WB2CBA/W5BAA-FT8-POCKET-TERMINAL/FT8 POCKET TEENSY 3.6/Pocket-FT8_Project Manual_May_2022.pdf

### Pocket FT8: A Palm Size FT 8 Decoder / Encoder For SOTA

Scope
This document is written to help you build your own self contained FT8 Rig. Listed below are the main features of the project.
- Small Size, 3.5” X 2.75” X 1.125”
- Mono Audio Input and Output for Transceiver Interface
- PTT Output To Control Transceiver
- SD Card Contact Logging
- 320 X 480 Resistive Color Touch Screen
- GPS Receiver For Setting Teensy Real Time Clock and Station Maidenhead Locator

Attributions
This project is based on the FT8 Decoding Library by Karlis Goba: https://github.com/kgoba/ft8_lib

DSP Audio Architecture
Decoding FT8 requires significant data storage and processing speed.

The Teensy Audio Library has been modified to allow Analog to Digital conversion to be run at the rate of 32000 samples per second. The receive data is decimated by a factor of 5. This allows Receive Audio Data Processing to be done at 6400 Hz. The 6400 Hz audio processing rate with a 2048 FFT to process the received audio for FT8 decoding yields a bin spacing of 3.125 Hz.

The algorithms developed by Karlis Goba use the 3.125 Hz spaced FFT bins to be screened in both frequency and time so that errors in symbol frequency and time reception can be overcome to provide really great FT8 decoding. The end spacing of the FT8 algorithms is 6.25 Hz as required by FT8 protocol.

Target Transceiver
This unit has been designed to directly interface with the popular uSDX transceivers such as the uSDX Mono and the uSDX Tri-Band Pocket Radio.


The photo below shows the pocket_FT8 display on boot up.

The FT8_Log.txt is the filename used to store operating log data. The line “W5BAA:EM00 is the raw text stored in a file entitled “Station_Data.txt” which you create to store your station details.
The lines “W5BAA” and “EM00” is the parsed station data.

The Synchronizing With RTC and FT8 Synched With World Lines are displayed at startup while the unit synchronizes the FT8 decode algorithm with the Teensy 3.6 Real Time Clock.

Finally, the last line in green shows the revision level of the software.


Decoded FT8 Signals

This photo shows decoded signals after the unit is synchronized. Up to ten FT8 Signals may be decoded and displayed per FT8 period.

Overall Architecture
The project consists of the following hardware modules:

Teensy 3.6
The Teensy 3.6 is ideal for this application since it has both Analog to Digital (ADC) inputs and Digital to Analog (DAC) outputs. This allows the DSP algorithms to be implemented with minimal parts count.

The Teensy 3.6 is supported by the feature rich Teensy Audio Library found here: https://www.pjrc.com/teensy/td_libs_Audio.html

The original source for the Teensy 3.6 may be found here: https://www.pjrc.com/store/teensy36.html Unfortunately, PJRC has been out of stock for some time.

A viable alternative may be Ali Express as shown below.

https://nl.aliexpress.com/item/3256803451619522.html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 45650&crea=en1005003637934274&netw=u&device=c&albpg=1480551745650&albpd=en10050036 37934274&gclid=Cj0KCQjw-JyUBhCuARIsANUqQ_KSC-1gYJm9mQVjuHfPr4Px892twd8chFpD1A1u9B4owOFrEE6DkJgaAnG5EALw_wcB&gclsrc=aw.ds& aff_fcid=03a8c9757c6340c082a8e60e83739c5a-1653047603438-09475-UneMJZVf&aff_fsk=UneMJZVf&aff_platform=aaf&sk=UneMJZVf&aff_trace_key=03a8c9757c6340 c082a8e60e83739c5a-1653047603438-09475-UneMJZVf&terminal_id=699c94115ff747c3adbf46e954a344ee&afSmartRedirect=y&gatewayAdapt= 4itemAdapt (https://nl.aliexpress.com/item/3256803451619522.html?_randl_currency=USD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)

Adafruit 320 X 480 TFT Touchscreen https://learn.adafruit.com/adafruit-3-5-color-320x480-tft-touchscreen-breakout

Microchip MCP 3422 Analog to Digital IC https://www.microchip.com/en-us/product/MCP3422

u-blox NEO-6M GPS Module with Battery Backup
https://www.amazon.com/GY-GPS6MV2-NEO6MV2-Antenna-Arduino-Control/dp/B07QMTM5YM

The Teensy 3.6 communicates with the MCP 3244 A/D via an I2C Bus while the Touchscreen Display is interfaced via an SPI Bus.

The Microchip MCP 3422 Analog to Digital IC is used to interface the Touch Screen touch point coordinates to the Teensy processor. One may ask “Why not use two of the Analog Pins on the Teensy?”. An attempt was made to do just this. However, the high rate of A to D sampling required by the Teensy Audio Library swamps out polling of the touch screen analog data. So, the MCP3422 is used so the touch point data may be fed to the Teensy 3.6 via the I2C Bus.

The Teensy communicates with the GPS receiver via a serial data port. The GPS data is interfaced using the NEMA protocol. The software uses the NEMA data to set the RTC and Station Maidenhead Locator.

## Module Connections

The project connections are shown on the drawing shown below.

The unit may be assembled using perf board and wire wrap wire to make connections between modules.

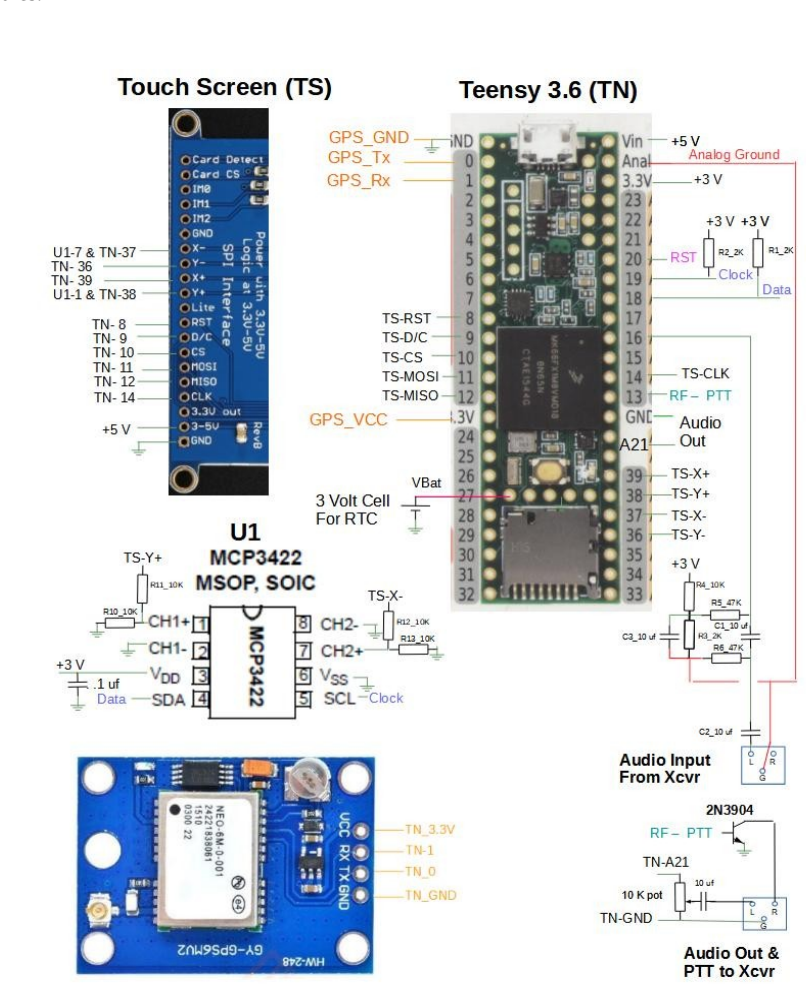
[picture p12: figure]

## Adafruit 480 X 320 Display Gotcha!

The Adafruit Display requires that you fill in solder bridge IM2 in order to put the display in the SPI Interface mode. If you do not install this bridge you will only get a totally white screen.


## GPS Receiver NEMA Sentences

The application software uses the TinyGPS.h library for parsing the NEMA sentences produced by the GPS receiver module. This library uses the NEMA GPRMC Sentence or the GPGGA Sentence to provide date time data. So, please ensure that your GPS module produces one of these two sentences.

## Installing Firmware on Teensy 3.6

The firmware is loaded by using the USB Serial bootloader provided with the Teensy 3.6.

When you first connect the Teensy to your computer using a USB be patient and allow the Teensy and Computer go thru the handshaking ritual to establish the serial connection.

The firmware is supplied as a hex file which can be loaded with the TEENSY.EXE application. You can download TEENSY.EXE from this site: https://www.pjrc.com/teensy/loader_win10.html

This website has complete instructions on using TEENSY.EXE.

The Pocket_FT8 firmware is provided as a file such as : Pocket_FT8_GPS_OCT_2021_2.ino.TEENSY36.hex

A screen shot of the firmware being loaded is shown below:


Real Time Clock
The Teensy Real Time Clock (RTC) is used to display relative time and to mark log entries with date – time groups.

The software may be manually synchronized using the touch screen button marked “SYNC”. This technique is copied from the work done by Karlis Goba and is a very effective way to manually sync the Pocket_FT8 rig with the current worldwide FT8 traffic.

A 3 volt coin cell battery is required to be connected to the Vbat pin on the Teensy 3.6 to make the RTC work.

Setting Your Call and Location
Your call and location data are stored on an SD Card as simple text file. Use Notepad to create a text file called “Station_Data.txt”.

The content of this file should be a single line in the form of YourCall:Madienhead_Locator.

For example here is the line I use: W5BAA:EM00.

Pocket_FT8 User Operation


The unit uses the Portrait Mode of display and the hardware has been designed so that the Pocket_FT8 may be operated in your hand. The unit shown above is my prototype.

The user is presented with a number of data displays, touch buttons and touch areas as shown above.

Display Items
Starting at the top, the received audio / FT8 spectrum / waterfall is shown. The vertical red line on the spectrum display shows the FT8 transmit audio frequency.

Immediately below the waterfall the RTC Time is displayed as the default option. If the GPS mode of setting your Maidenhead location is activated, the GPS Time is displayed to the right of the RTC time.

In the middle pane the received FT8 traffic is shown. Up to ten FT8 signals may be decoded and displayed for each FT8 period.

Touch Areas

Two touch areas are provided.

One is the FT8 waterfall. Touching this area moves the FT8 transmit audio frequency. The red vertical line moves to show the selected FT8 transmit audio frequency.

The other touch area is immediately below the RTC Date Time or GPS time line. You may touch one of the displayed FT8 messages to capture the call sign of the transmitting station. The call of the selected station is displayed above the two rows of touch buttons displayed at the bottom of the screen.

In the example shown below on the left, the message “CQ AA9RR EN62 1708” has been touched to capture the call sign “AA9RR”.

Further, the “CALL” button has been touched to compose the message “ AA9RR W5BAA EM00” as shown below on the right.

The value “1708” shown in the decoded FT8 message is the distance between Maidenhead Locator EN62 and Maidenhead Locator EM00, my station Locator.


Touch Buttons

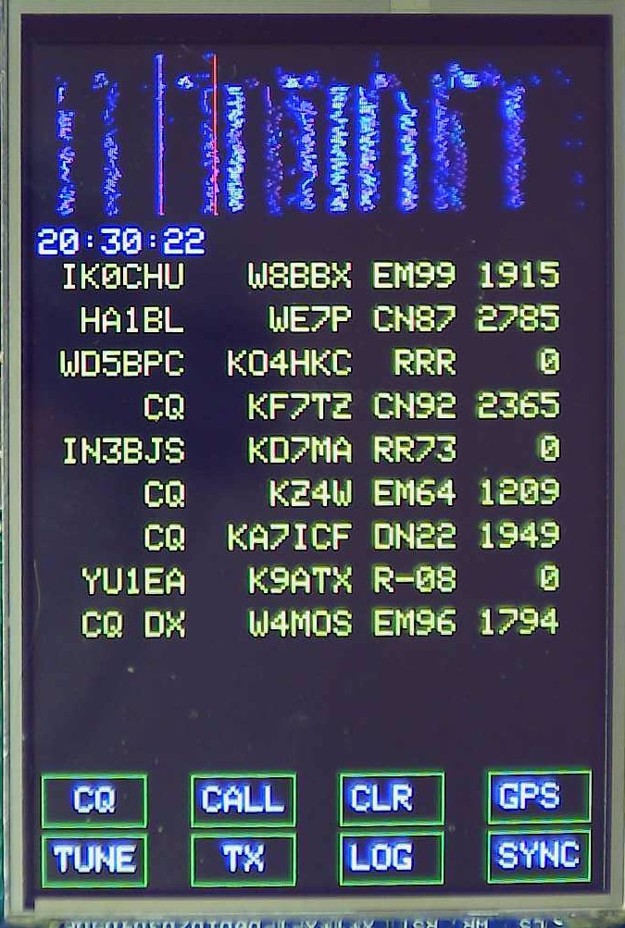
[picture p13: figure]

Ten touch buttons are displayed at the bottom of the screen. The buttons will be displayed with a Green or Red outline as explained below:

CQ places the unit in the beacon (CQ ing) mode. Red means CQ mode is selected.

Call places the unit in the QSO mode. Red means the QSO mode is selected.

CLR clears the out going message and the displayed out going message.

GPS is used to synchronize the Teensy RTC with the GPS Time generated by the GPS Receiver Module. When this box is Red, the GPS Time is displayed. If the value shown in 00: 00: 00: the GPS Receiver has not found a valid Time fix. When a valid GPS Time is found, the Teensy RTC is set to the GPS Time. At this point you may touch the GPS button again to turn off the GPS Time display and RTC synchronization. When the unit is turned off and then turned back on the FT8 decoding algorithm will be set to the RTC at 0, 15, 30 or 45 seconds. So, manual synchronization will not be required.
In addition, the Station Maidenhead Locator will be set using the GPS Coordinates data.

Tune puts the transceiver in transmit with with a steady tone at the frequency shown by the vertical red line in the spectrum display. And, the PTT output will be driven to ground to key the associated transceiver. Further the TX box will be shown in Red.

Tx indicates the the unit is either in the receive or transmit mode. When green, the unit is receiving. When Red the unit is transmitting. Touching this button has no effect. It is simply an
indicator.

Log is used to toggles the traffic logging on to the SD card on or off. Red means logging is on.

Sync allows the user to manually synchronize the FT8 receiver with the rest of the FT8 world. The Sync button has no effect on the Teensy RTC or Station Maidenhead Locator.

CQ (Beaconing) Operation Mode

In the CQ mode the user simply touches the CQ button and the button turns red and then the user may observe the traffic. As stations respond to your CQ call, their FT8 messages are displayed in green above the last station call selected. In the case below, Station “VE3XN” at Locator EN93 has responded to my CQ message.


Further, if the LOG button is touched the button turns red and the traffic logging to SD card is turned on.

Please note that when the TX button outline turns red the composed message shown in white is being transmitted. In the example above, the message CQ W5BBA EM00 is being transmitted at the time of 19: 38: 20:.

In the CQ mode four messages may be generated and transmitted as shown below:

CQ W5BAA EM00

VE3XN W5BAA EM00

VE3XN W5BAA -5

VE3XN W5BAA RR73

A traffic manager algorithm is called after each FT8 period is decoded. The algorithm searches the decoded messages for stations calling your station call, in this example “W5BAA”.

If no calling stations are recognized, the algorithm will set the CQ message to be sent on the next FT8 period.

When the algorithm recognizes a calling station the other three standard messages listed above are sent succession. After sending “RR73” the algorithm sends the CQ message on every other FT8 period.

Logged Message Example for CQ (Beaconing) Operation Mode

Shown below is a log of messages received and sent while the unit was in the CQ mode.

19/ 5/2022 19:16:50 W5BAA VE3XN EN93 2146
19/ 5/2022 19:16:50 VE3XN W5BAA EM00
19/ 5/2022 19:56: 5 W5BAA KN8DMK EM89 1763
19/ 5/2022 19:56:50 W5BAA VA3CK FN03 2279 19/ 5/2022 19:56:50 VA3CK W5BAA EM00
19/ 5/2022 19:57:20 W5BAA VA3CK -05 0
19/ 5/2022 19:57:20 VA3CK W5BAA RR73
19/ 5/2022 20: 6:34 W5BAA KF7TZ CN92 2365 19/ 5/2022 20: 6:35 KF7TZ W5BAA RR73
19/ 5/2022 20:13:49 W5BAA WA3GDB EM95 1765 19/ 5/2022 20:13:50 WA3GDB W5BAA RR73 19/ 5/2022 20:14:50 W5BAA WA3GDB EM95 1765 19/ 5/2022 20:14:51 WA3GDB W5BAA EM00 19/ 5/2022 20:15:20 W5BAA WA3GDB EM95 1765 19/ 5/2022 20:15:21 WA3GDB W5BAA RR73 19/ 5/2022 21:27:20 W5BAA K7OGW -02 0

CALL (QSO) Operation Mode

In the Call Mode of operation you will first select a message from the station you wish to call.
In the example shown below the message “CQ AA9RR 1708” is touched to capture the call sign “AA9RR” shown in white text immediately above the CQ and Call touch buttons. Then, by touching the CALL button, the QSO mode is activated and the first message to be sent to AA9RR is composed as “AA9RR W5BAA EM00”. Please note that the CQ and Call touch buttons are interlocked so that only one mode of operation may be activated at a time. This is indicated by the two touch buttons changing color.

Once a station call is selected and the QSO mode is activated, the QSO algorithm will call the selected station up to five times. After each call to the station the algorithm will listen for a reply message from the station called. If no reply is received after five listening periods, no further calls will be made.

When a reply is received, the algorithm will proceed with composing and sending a signal strength message and/or a RR73 message such as:

AA9RR W5BAA -5

AA9RR W5BAA RR73

## Actual Pocket-FT8 Activity Report

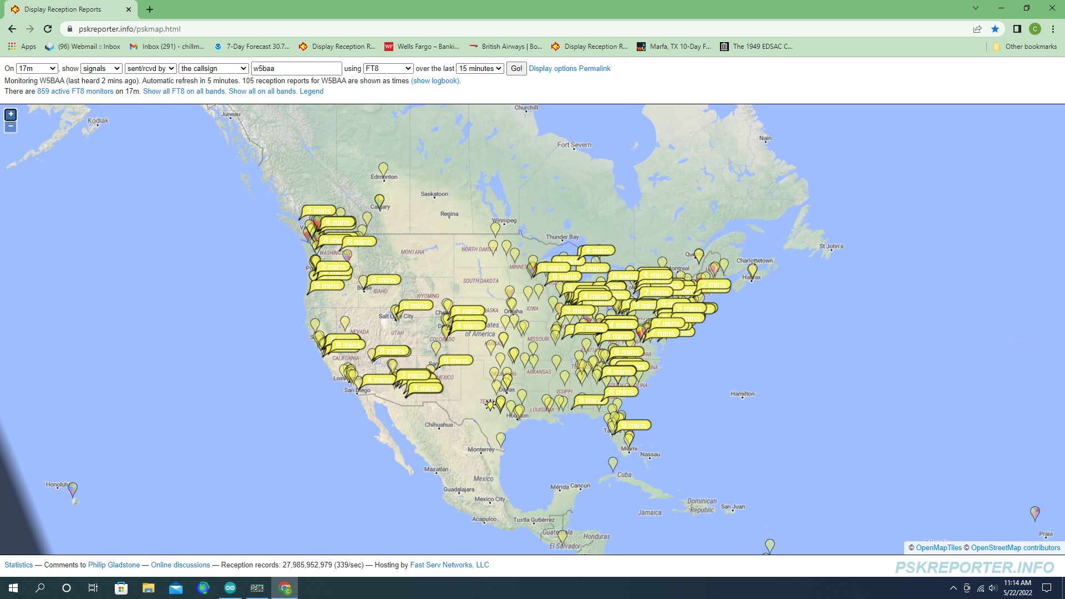
[picture p14: figure]
