WB2CBA/W5BAA-FT8-POCKET-TERMINAL/ADX FT8 POCKET Top and Bottom Plate Files/ADX FT8 POCKET LM2576 Module DISCO Board Power Schematic.pdf

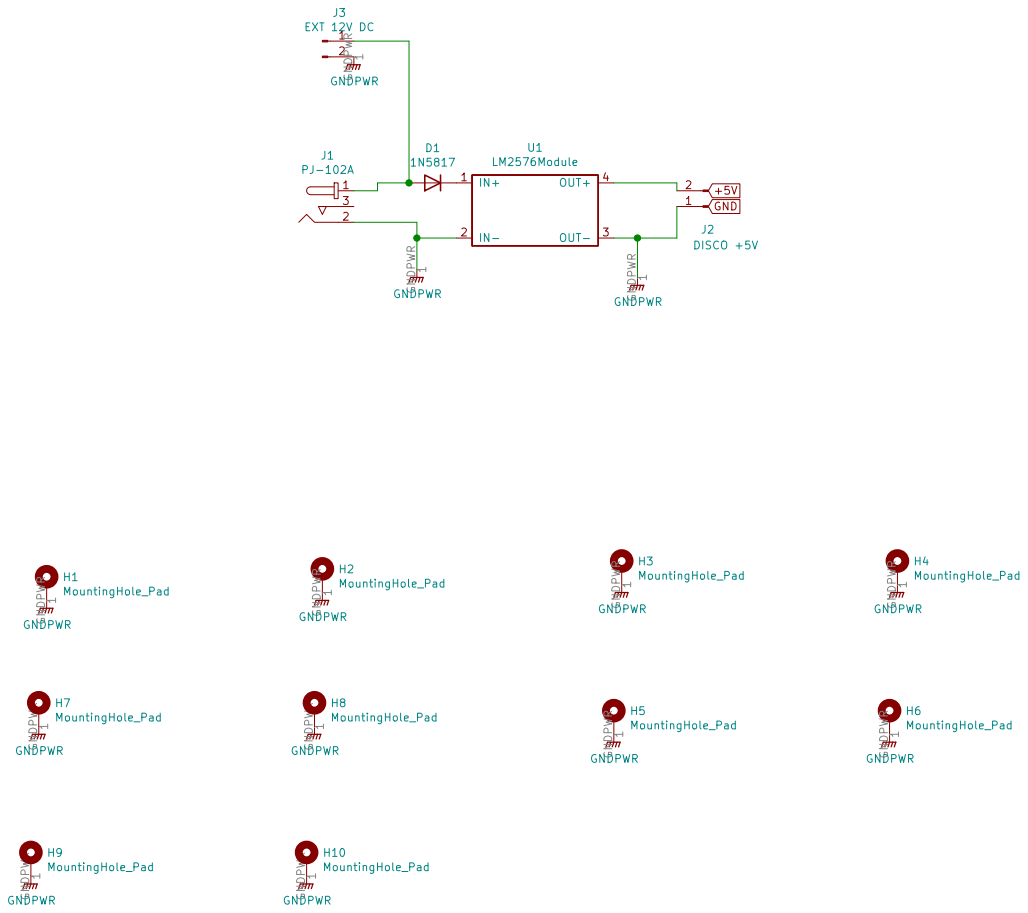
[picture p15: page 1]
