WB2CBA/W5BAA-FT8-POCKET-TERMINAL/(threads)

Thread 1 (2022-12-11):

Touch not working

ESSCHENK1, 2022-12-11:
Hello,

I have a problem with the Touchscreen.
that is not working.
could it be that the mcp3422 is a wrong one.
there are
Multichannel and single channel versions.
When I look at the X and Y output of the touchscreen with the scope, I see the signal jump.
When I press the touch screen.
So the screen seems to be working fine.
I hope someone gives a hint where I should look for this.

I have build the one with the Teensy 4.1  pcb v4.1_i0c

73 Ed
PA1TR
